IowaScaledEngineering/ckt-timelock/doc/timelock-bag-top.odt

Iowa Scaled Engineering, LLC

http://iascaled.com/

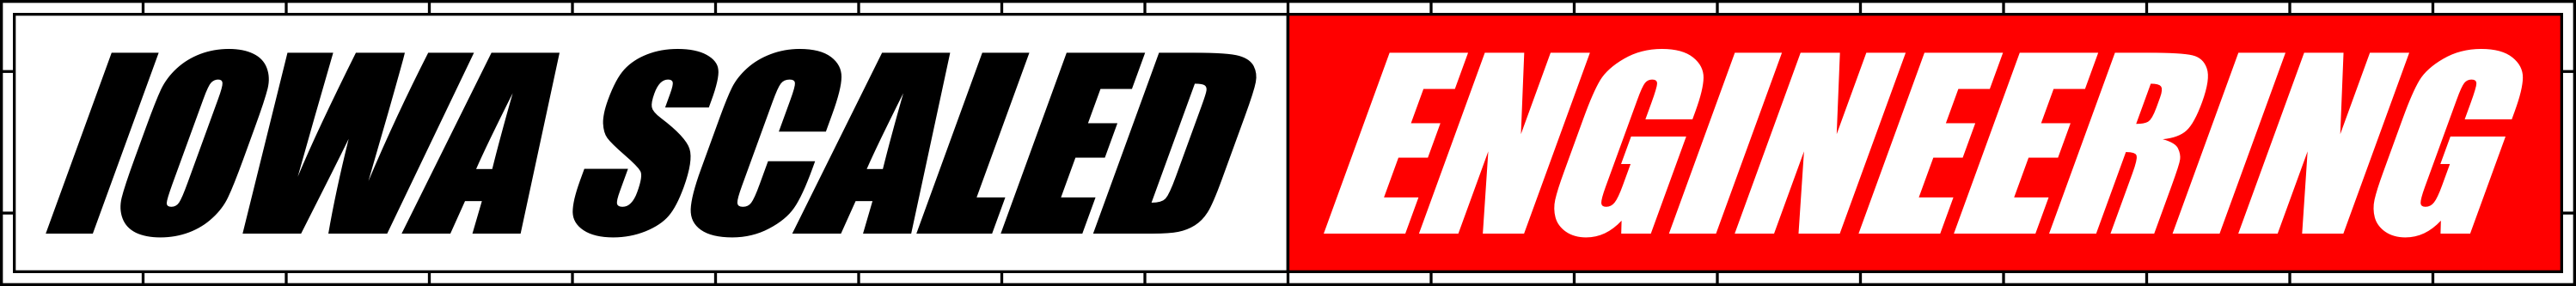
[picture p1: figure]

Time Lock Switch Controller

The CKT-TIMELOCK provides an easy way to simulate prototypical time-locked or dual-control power switches on your model railroad.

CKT-TIMELOCK
