IowaScaledEngineering/ckt-timelock/pg/ckt-timelock-v1.0-r902/ckt-timelock-pcb.pdf

# ckt-timelock.pcb

# 1. Table of Contents (This Page) Created on Sun Jun 1 10:29:40 2014

# 2. component 3. solder 4. outline 5. plated-drill 6. unplated-drill 7. componentmask 8. soldermask 9. topsilk 10. bottomsilk 11. toppaste 12. topassembly 13. bottomassembly 14. fab

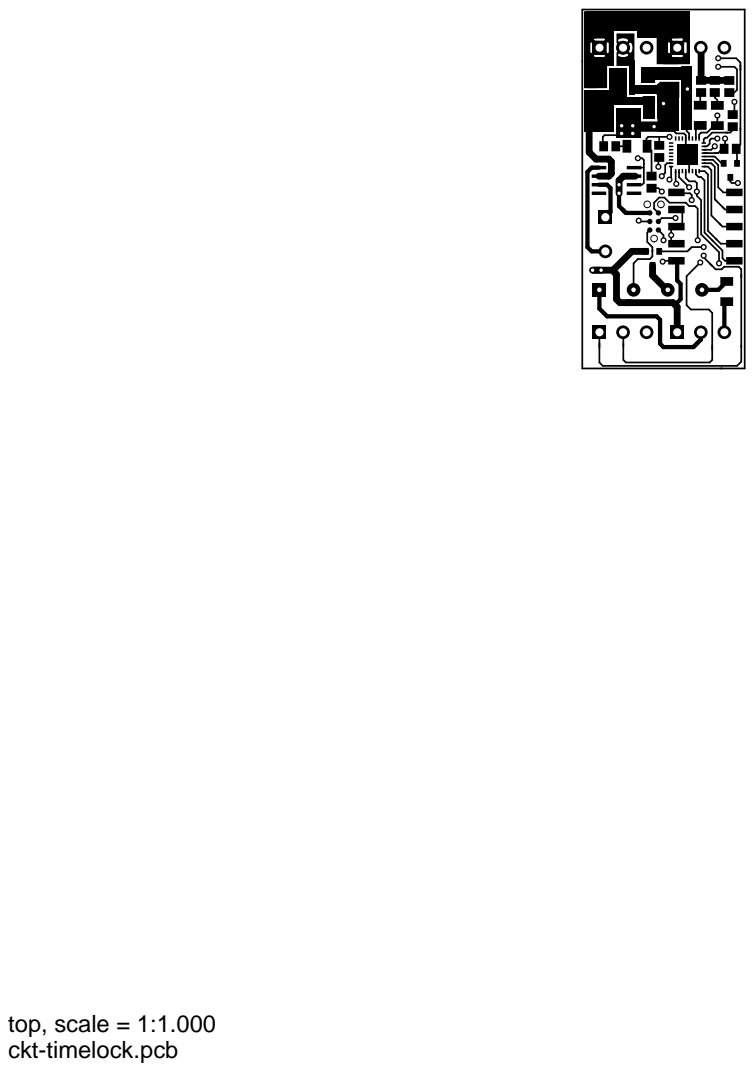
[picture p2: page 2]
top, scale = 1:1.000

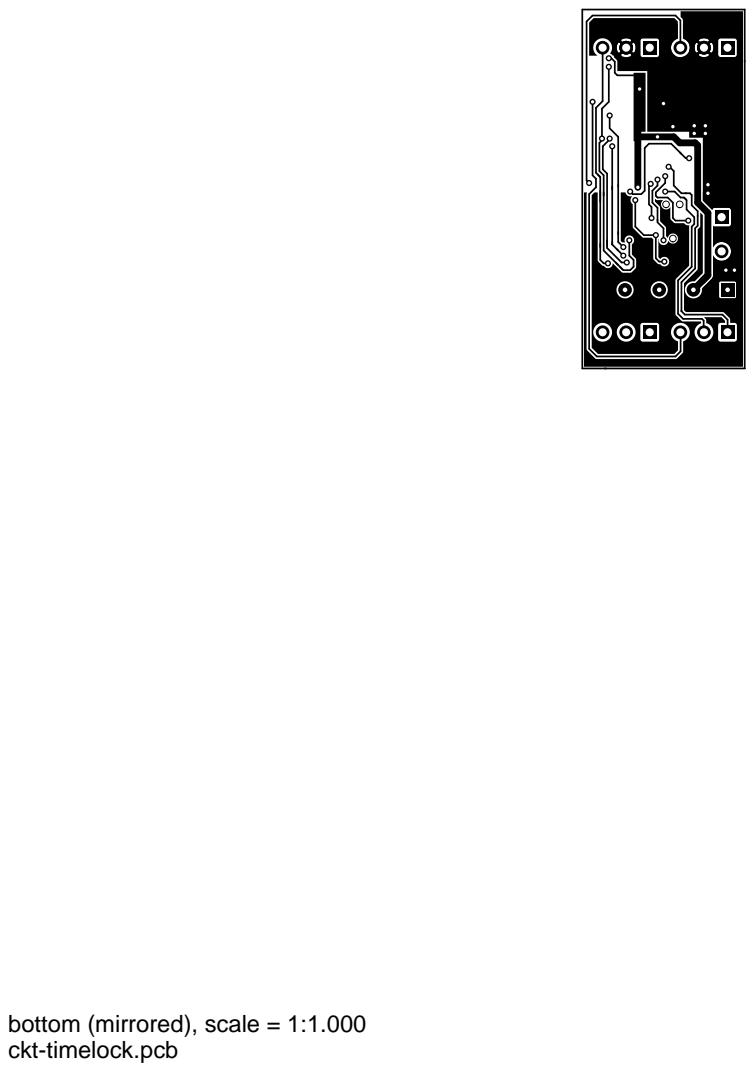
[picture p3: page 3]

bottom (mirrored), scale = 1:1.000

outline, scale = 1:1.000

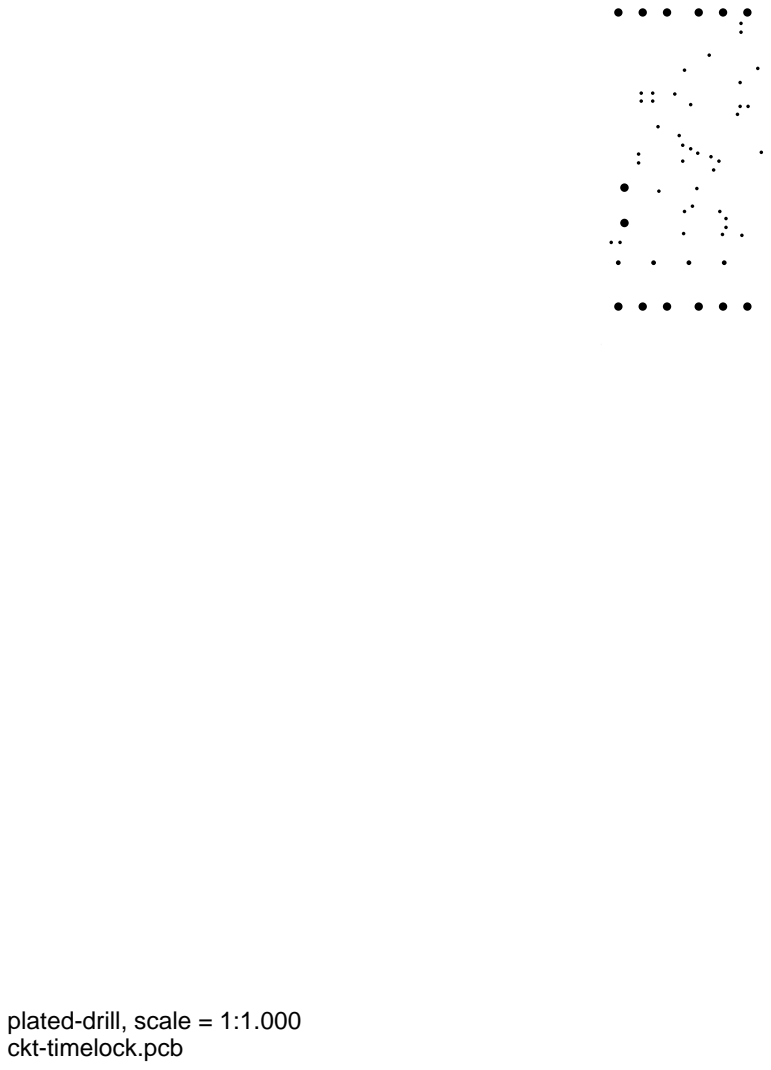
[picture p4: page 5]

plated-drill, scale = 1:1.000

unplated-drill, scale = 1:1.000

topmask, scale = 1:1.000 bottommask (mirrored), scale = 1:1.000

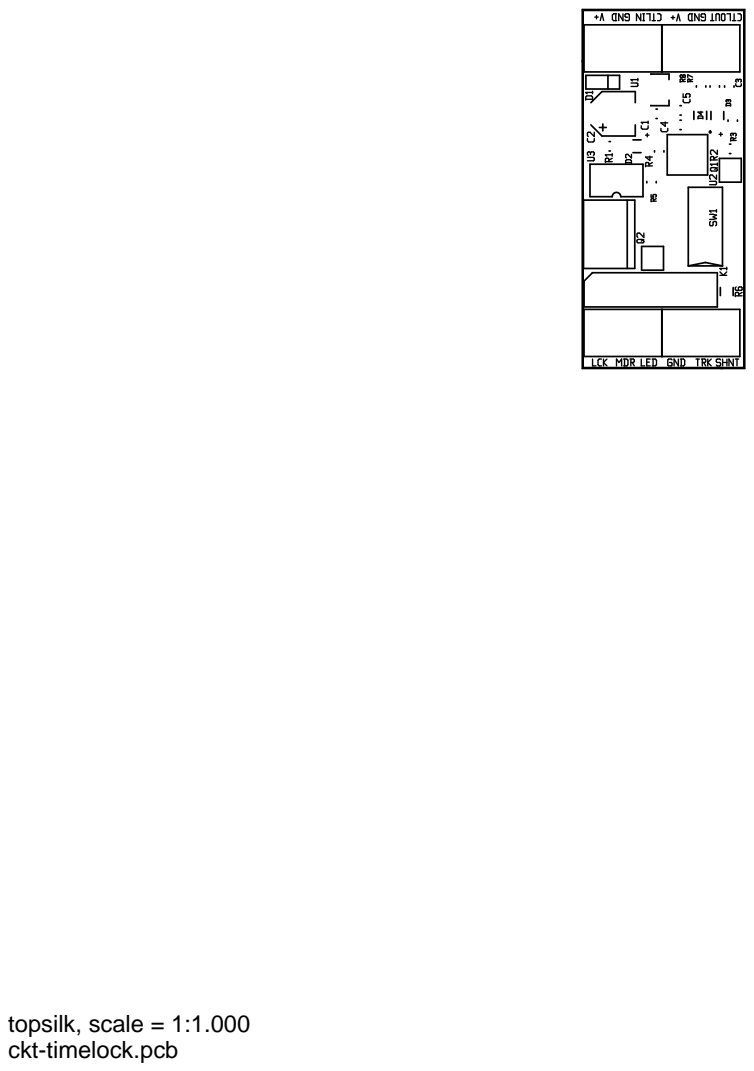
[picture p5: page 9]
topsilk, scale = 1:1.000

bottomsilk (mirrored), scale = 1:1.000

toppaste, scale = 1:1.000

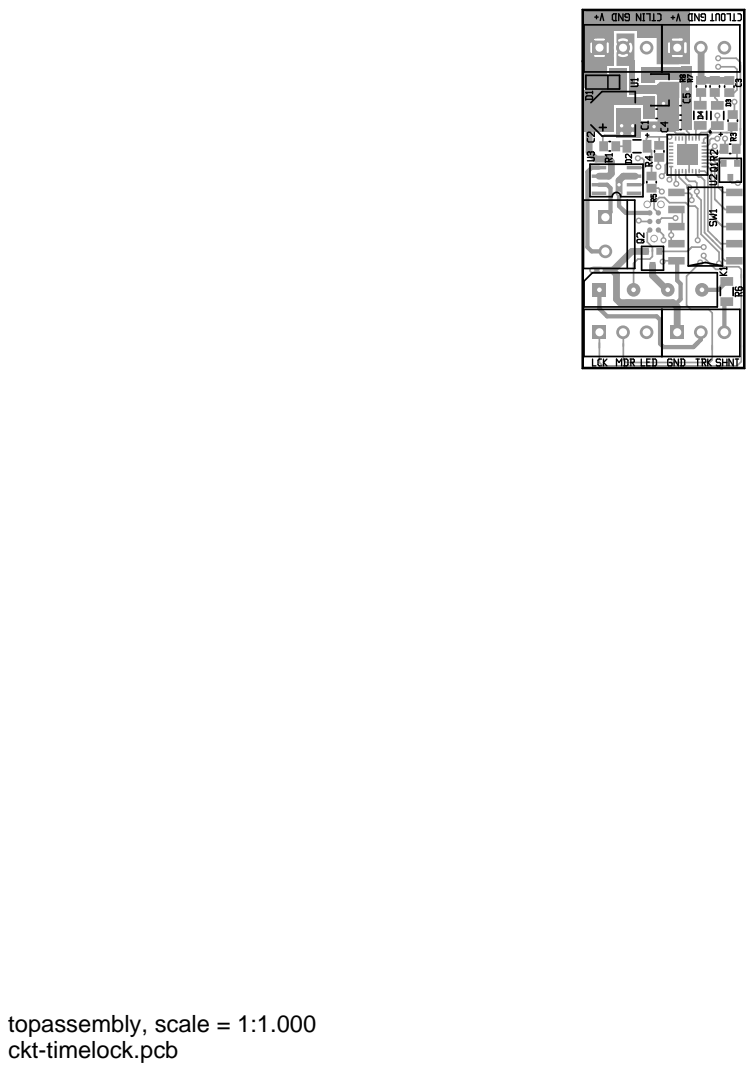
[picture p6: page 12]
topassembly, scale = 1:1.000

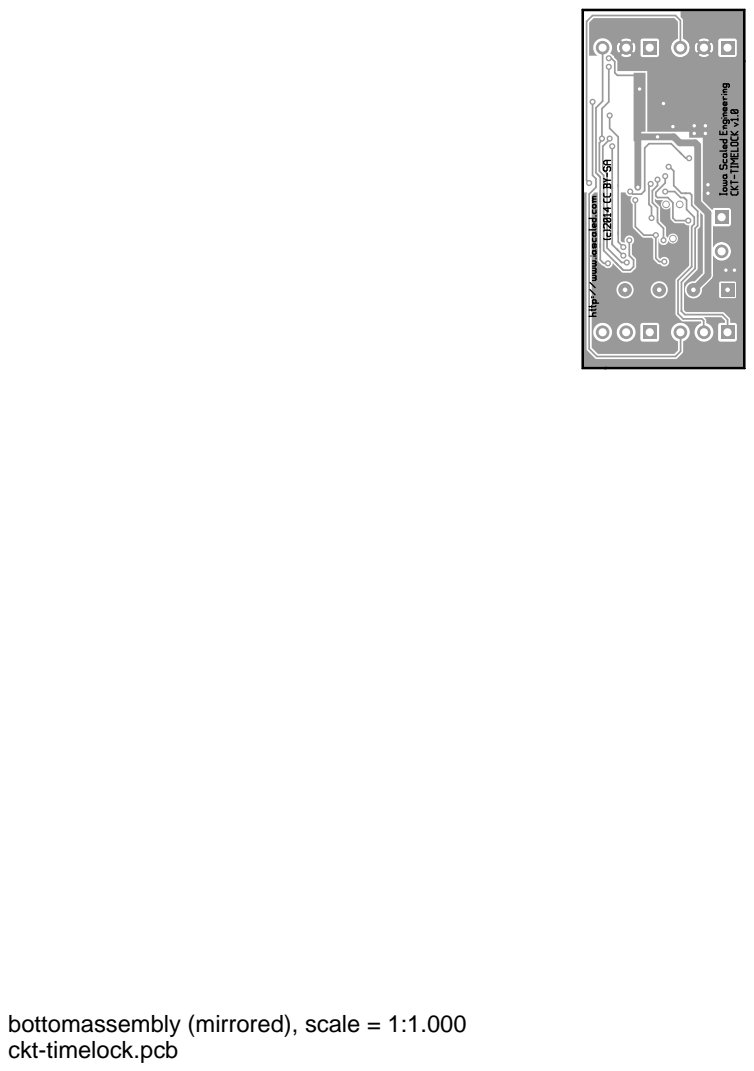
[picture p7: page 13]

bottomassembly (mirrored), scale = 1:1.000

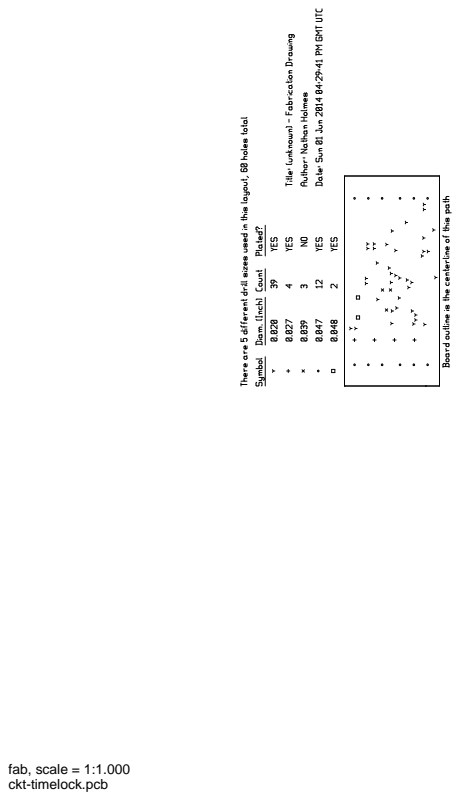
[picture p8: page 14]
fab, scale = 1:1.000
