IowaScaledEngineering/ckt-timelock/pg/ckt-timelock-v1.0-r902/ckt-timelock.pdf

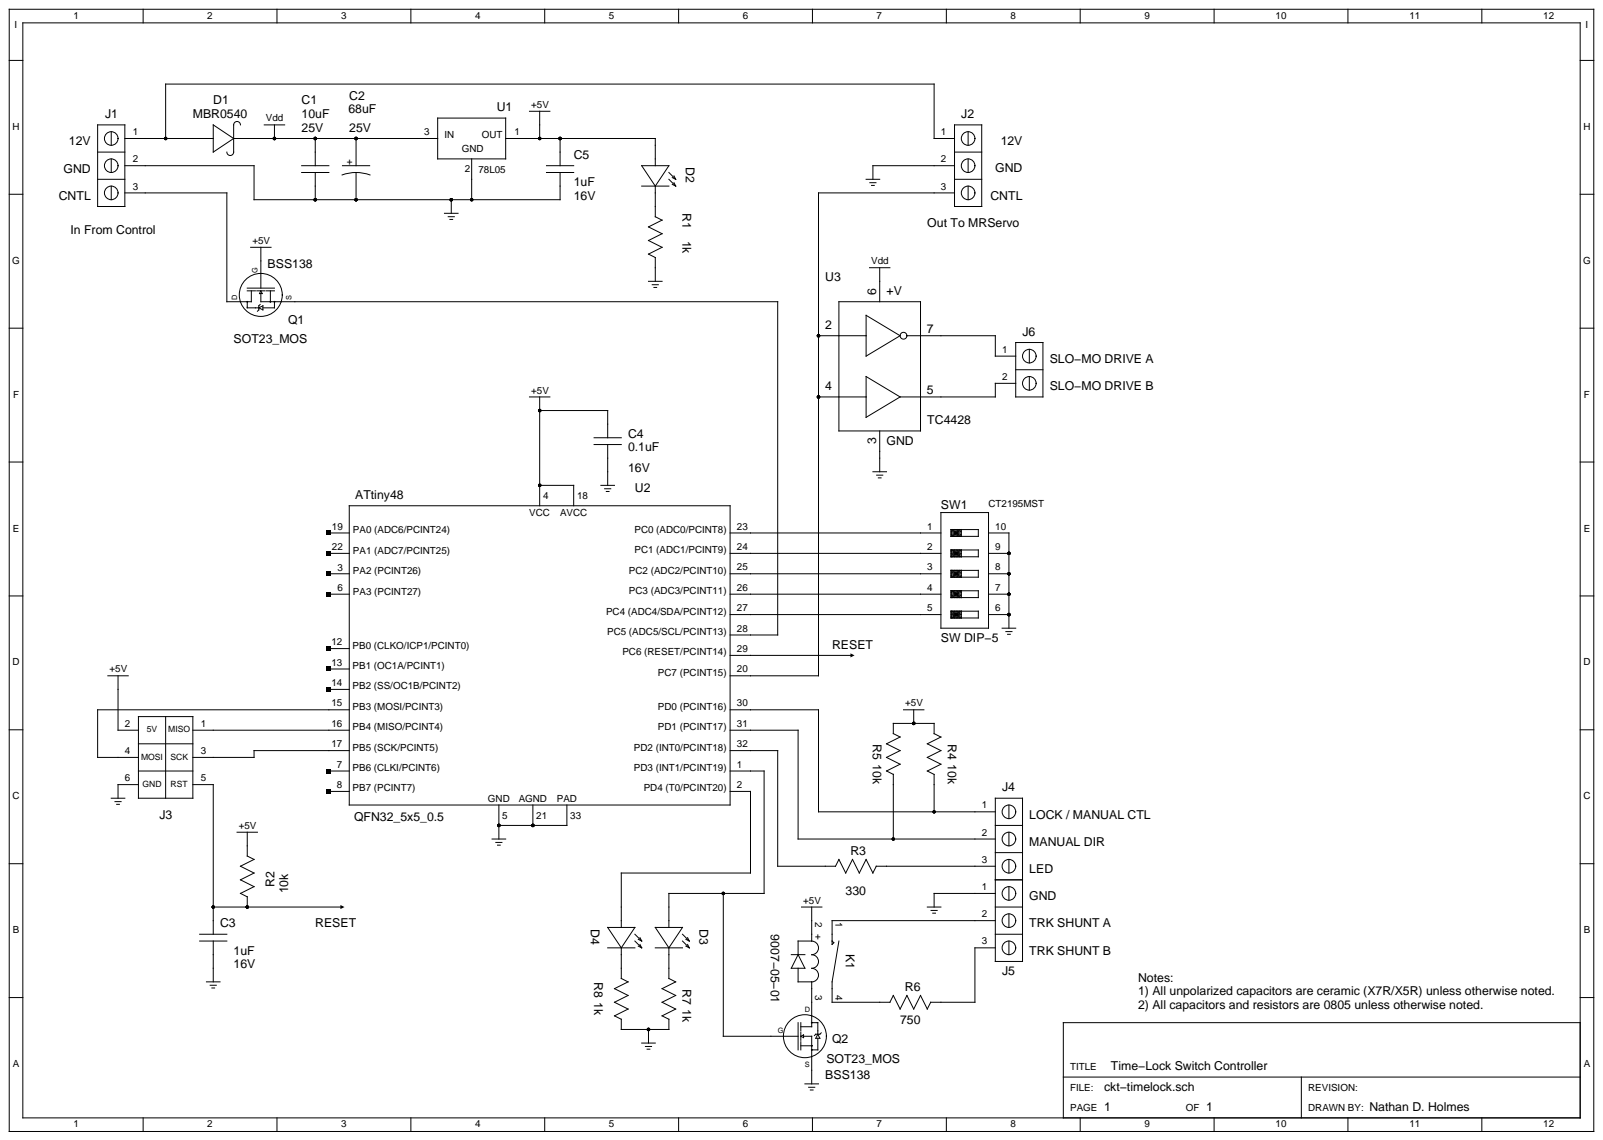
[picture p9: page 1]

Out To MRServo In From Control

24 PC1 (ADC1/PCINT9) | 2 | 9
25 PC2 (ADC2/PCINT10) | 3 | 8
26 PC3 (ADC3/PCINT11) | 4 | 7

5V | MISO

MOSI | SCK

Notes:
1) All unpolarized capacitors are ceramic (X7R/X5R) unless otherwise noted.
2) All capacitors and resistors are 0805 unless otherwise noted.

Time−Lock Switch Controller
ckt−timelock.sch
