IowaScaledEngineering/ckt-timelock/(list of files, drawings)

Other design files:
pcb/ckt-timelock.pcb
