IowaScaledEngineering/ckt-timelock/(threads)

Thread 2 (2021-11-18):

Fix U2/U3 pin 1 markers

petersenm, 2021-11-18:
