IowaScaledEngineering/ckt-timelock/(commit log)

2014-05-28 Time lock schematic and symbols
    [ckt-timelock.sch]
2014-05-28 Intermediate checkin of changes
    [ckt-timelock.sch]
2014-05-28 More updates
    [ckt-timelock.sch]
2014-05-29 Morning updates
    [ckt-timelock.sch]
2014-05-29 Forgot to save most recent changes first
    [ckt-timelock.sch]
2014-05-30 Last commit before starting pcb for timelock
    [ckt-timelock.pcb, ckt-timelock.sch]
2014-05-30 Done, passes DRC and netlist
    [ckt-timelock.pcb]
2014-05-30 Fix schematic for fet driver
    [ckt-timelock.sch]
2014-05-30 Change canvas size
    [ckt-timelock.pcb]
2014-06-01 Changes & fixes
    [ckt-timelock.pcb]
2014-06-01 Move programming header away from terminal block
    [ckt-timelock.pcb]
2014-06-01 Fix PB5 labeled as PB4 - pin number and other functions were correct
2014-06-01 PG out the timeclock
    [ckt-timelock.bottom.gbr, ckt-timelock.bottommask.gbr, ckt-timelock.bottompaste.gbr, ckt-timelock.bottomsilk.gbr, ckt-timelock.fab.gbr, ckt-timelock.outline.gbr, ckt-timelock.top.gbr, ckt-timelock.topmask.gbr]
2014-06-22 Initial cut of source that compiles for the time lock
2014-06-22 Add dual control switch code
2014-08-17 Added MRServo and stall machine diagrams
2014-08-17 Fixes for Michael's issues 1) Goes back to locked if the lock switch is relocked during timer 2) If time lock switch is turned back to lock before the switch returns normal, will remain unlocked 3) H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
    [ckt-timelock.c]
2015-07-02 Drawing with LEDs for Nathan
2015-07-16 Start of LED descriptions for manual
2015-07-23 Fixed LEDs in diagram. Fixed switch naming to match assembled PCB.
2016-03-15 Add ability for local occupancy sensor to override time delay
2016-04-28 Revert "Add ability for local occupancy sensor to override time delay"
    This reverts commit 6fdf49b0211479a39d71e74690ec703a061126d6.
    [ckt-timelock.c]
2021-01-25 First draft of a v2 timelock
    [ckt-timelock.sch]
2021-01-26 Initial draft of PCB
    [ckt-timelock.pcb, ckt-timelock.sch]
2021-01-26 Add usual text
    [ckt-timelock.pcb]
2021-01-26 Add J4A, a pseudo-qwiic connector
    [ckt-timelock.pcb, ckt-timelock.sch]
2021-02-01 Move VCC terminal on panel connector to control input
    [ckt-timelock.sch]
2021-02-01 Change pin 2 on the panel header
    [ckt-timelock.pcb]
